RuhaanSJ/Smartwatch/Features.docx

Features

1. Time
2. Stopwatch
3. Alarm with vibration
4. Step Tracker
5. Notifications Readout
6. USB C charging port
7. Reminders Readout
8. Weather Forecast Readout
9. Phone Media control (play, pause, skip, etc.)
