RuhaanSJ/Smartwatch/Hardware/Extra/Top/Smartwatch-EXTRA-TOP_BOM.xlsx

Design Name -- Revision Code / Designer or Organization Name |  |  |  |  |  |  |  |  |  |  | Total | $32.52 | Total (in Bulk) | $27.30
BOM # | Comment | Designator | Description | Mounting Type | Package | Manufacturer | Manufacturer Part Number | Supplier | Supplier Part Number | Price per unit | Quantity | Total | Per 100 | Total
 | DigiKey
1 | NRF52832_MODULE_MDBT42 | U1 | Bluetooth Bluetooth v4.2 Transceiver Module 2.4GHz Integrated, Chip Surface Mount | SMD | 41-SMD Module | Seeed Technology Co., Ltd | 317030213 | Digi-Key | 1597-1434-ND | $10.10 | 1 | $10.10 | $10.10 | $10.10 | a
2 | FT231XS USB Serial | U3 | USB Bridge, USB to UART USB 2.0 UART Interface 20-SSOP | SMD | 20-SSOP | FTDI, Future Technology Devices International Ltd | FT231XS-U | Digi-Key | 768-1156-5-ND | $2.12 | 1 | $2.12 | $2.08 | $2.08 | a
3 | MIC5504-3.3V | LDO1 | Linear Voltage Regulator IC 1 Output 300mA SOT-23-5 | SMD | SOT23-5 | Microchip Technology | MIC5504-3.3YM5-TR | Digi-Key | 576-4764-1-ND | $0.11 | 1 | $0.11 | $0.08 | $0.08 | a
4 | MCP73831 T Li-Ion, Li-Pol Controller | CHRG1 | Charger IC Lithium-Ion/Polymer SOT-23-5 | SMD | SOT-23-5 | Microchip Technology | MCP73831T-2ACI/OT | Digi-Key | MCP73831T-2ACI/OTCT-ND | $0.56 | 1 | $0.56 | $0.44 | $0.44 | a
5 | CRYSTALECS-.327-12.5-12-C-TR (CRYSTAL) (32.7680kHz) | XTAL1 | 32.768kHz ±10ppm Crystal 12.5pF 90 kOhms 2-SMD, No Lead | SMD | 2-SMD, No Lead | ECS Inc. | ECS-.327-12.5-12-C-TR | Digi-Key | XC2288CT-ND | $0.60 | 1 | $0.60 | $0.54 | $0.54
6 | Cortex Debug Connector - 10 pin | DEBUG1 | Connector Header Through Hole 10 position 0.050" (1.27mm) | THT | NA | Amphenol ICC (FCI) | 20021111-00010T4LF | Digi-Key | 609-3712-ND | $0.69 | 1 | $0.69 | $0.53 | $0.53
7 | Schottky Diode | D1,D2,D3,D4 | Diode Schottky 30V 1.5A Surface Mount USC | SMD | USC | Toshiba Semiconductor and Storage | CUS15S30,H3F | Digi-Key | CUS15S30H3FCT-ND | $0.26 | 5 | $1.28 | $0.13 | $0.64
8 | Red LED | LED1,LED3 | Red 622nm LED Indication - Discrete 2.2V 0603 (1608 Metric) | SMD | 0603 | Inolux | IN-S63ATR | Digi-Key | 1830-1065-1-ND | $0.18 | 2 | $0.35 | $0.09 | $0.17
9 | Blue LED | LED2 | Blue 470nm LED Indication - Discrete 3V 0603 (1608 Metric) | SMD | 0603 | Inolux | IN-S63AT5B | Digi-Key | 1830-1061-1-ND | $0.18 | 1 | $0.18 | $0.09 | $0.09
10 | Yellow LED | LED4 | Yellow 590nm LED Indication - Discrete 2V 0603 (1608 Metric) | SMD | 0603 | Wurth Electronics Inc. | 150060YS75000 | Digi-Key | 732-4981-1-ND | $0.14 | 1 | $0.14 | $0.11 | $0.11
11 | Ambient Light Sensor | U4 | Optical Sensor Ambient 630nm Analog 0603 (1608 Metric) | SMD | 0603 | Inolux | IN-S63DTLS | Digi-Key | 1830-IN-S63DTLSCT-ND | $0.55 | 1 | $0.55 | $0.26 | $0.26
12 | MCP9808-MSOP8 | U5 | Temperature Sensor Digital, Local -40°C ~ 125°C 10 b 8-MSOP | SMD |  | Microchip Technology | MCP9808T-E/MS | Digi-Key | MCP9808T-E/MSTR-ND | $1.13 | 1 | $1.13 | $0.85 | $0.85
13 | NFET | Q1 | N-Channel 30V 500mA (Ta) 690mW (Ta) Surface Mount SOT-23-3 (TO-236) | SMD | SOT23-3 | ON Semiconductor | NTR4003NT3G | Digi-Key | NTR4003NT3GOSCT-ND | $0.27 | 1 | $0.27 | $0.09 | $0.09
14 | Vibration Motor | M1 | DC Motor Vibration, ERM 10000 RPM 3VDC | THT | Wire Leads | Jinlong Machinery & Electronics, Inc. | C0720B015F | Digi-Key | 1670-1030-ND | $3.54 | 1 | $3.54 | $2.61 | $2.61
15 | Micro USB | USB2 | USB - micro B USB 2.0 Receptacle Connector 5 Position Surface Mount, Right Angle | SMD | Flange, Horizontal | Amphenol FCI | 10118192-0001LF | Digi-Key | 609-4613-1-ND | $0.43 | 1 | $0.43 | $0.32 | $0.32
16 | CONN_07-1.27MM | J1,J3,J4 | 50 Positions Header Connector 0.050" (1.27mm) Through Hole Gold | THT |  | Sullins Connector Solutions | GRPB501VWVN-RC | Digi-Key | S9014E-50-ND | $3.11 | 3 | $9.33 | $2.49 | $7.47
17 | Tiny Rectangular Switch | SW1,SW2 | Tactile Switch SPST-NO Top Actuated Surface Mount | SMD | Gull Wing | C&K Components | PTS830GM140 SMTR LFS | Digi-Key | CKN10587CT-ND | $0.57 | 2 | $1.14 | $0.46 | $0.91
18 | 10µH Inductor | L1 | 10µH Shielded Multilayer Inductor 250mA 1.05Ohm 0603 (1608 Metric) | SMD | 0603 | TDK Corporation | MLZ1608M100WTD25 | Digi-Key | MLZ1608M100WTD25 | $0.22 | 1 | $0.22 | $0.13 | $0.13
19 | 27 ohm resistor | R9, R10 | 27 Ohms ±1% 0.1W, 1/10W Chip Resistor 0603 (1608 Metric) Automotive AEC-Q200 Thick Film | SMD | 0603 | Stackpole Electronics Inc | RMCF0603FT27R0 | Digi-Key | RMCF0603FT27R0CT-ND | $0.01 | 2 | $0.01 | $0.01 | $0.01
20 | 1k Resistor | R3,R4,R15, R16 | 1 kOhms ±1% 0.1W, 1/10W Chip Resistor 0603 (1608 Metric) Automotive AEC-Q200 Thick Film | SMD | 0603 | Stackpole Electronics Inc | RMCF0603FT1K00 | Digi-Key | RMCF0603FT1K00CT-ND | $0.01 | 4 | $0.02 | $0.01 | $0.03
21 | 10k Resistor | R1,R2,R5,R7,R17,R18,R19 | 10 kOhms ±1% 0.1W, 1/10W Chip Resistor 0603 (1608 Metric) Automotive AEC-Q200 Thick Film | SMD | 0603 | Stackpole Electronics Inc | RMCF0603FT10K0 | Digi-Key | RMCF0603FT10K0CT-ND | $0.01 | 6 | $0.04 | $0.01 | $0.04
22 | 100k Resistor | R8,R12,R13,R14 | 100 kOhms ±1% 0.1W, 1/10W Chip Resistor 0603 (1608 Metric) Automotive AEC-Q200 Thick Film | SMD | 0603 | Stackpole Electronics Inc | RMCF0603FT100K | Digi-Key | RMCF0603FT100KCT-ND | $0.01 | 4 | $0.02 | $0.01 | $0.03
23 | 4.7k resistor | R11 | 4.7 kOhms ±1% 0.1W, 1/10W Chip Resistor 0603 (1608 Metric) Automotive AEC-Q200 Thick Film | SMD | 0603 | Stackpole Electronics Inc | RMCF0603FT4K70 | Digi-Key | RMCF0603FT4K70CT-ND | $0.01 | 1 | $0.01 | $0.01 | $0.01
24 | 390k resistor | R6 | 390 kOhms ±1% 0.1W, 1/10W Chip Resistor 0603 (1608 Metric) Automotive AEC-Q200 Thick Film | SMD | 0603 | Stackpole Electronics Inc | RMCF0603FG390K | Digi-Key | RMCF0603FG390KCT-ND | $0.01 | 2 | $0.01 | $0.01 | $0.01
25 | 47 pF Capacitor | C7, C9 | 47pF ±5% 50V Ceramic Capacitor C0G, NP0 0603 (1608 Metric) | SMD | 0603 | Walsin Technology Corporation | 0603N470J500CT | Digi-Key | 1292-1528-1-ND | $0.01 | 2 | $0.02 | $0.01 | $0.01
26 | 12pF capacitor | C3,C4 | 12pF ±5% 50V Ceramic Capacitor C0G, NP0 0603 (1608 Metric) | SMD | 0603 | Walsin Technology Corporation | 0603N120J500CT | Digi-Key | 1292-1480-1-ND | $0.01 | 100 | $1.19
27 | 100 nF Capacitor | C5,C10,C14,C17 | 0.1µF ±5% 16V Ceramic Capacitor X7R 0603 (1608 Metric) | SMD | 0603 | Yageo | CC0603JRX7R7BB104 | Digi-Key | 311-1776-1-ND | $0.03 | 4 | $0.13 | $0.03 | $0.14
28 | 1uF capacitor | C1,C8,C11,C16 | 1µF ±10% 25V Ceramic Capacitor X5R 0603 (1608 Metric) | SMD | 0603 | Samsung Electro-Mechanics | CL10A105KA8NNNC | Digi-Key | 1276-1102-1-ND | $0.10 | 4 | $0.40 | $0.02 | $0.07
29 | 2.2u capacitor | C13,C18,C19,C21,C22,C23 | 2.2µF ±10% 16V Ceramic Capacitor X5R 0603 (1608 Metric) | SMD | 0603 | Samsung Electro-Mechanics | CL10A225KO8NNNC | Digi-Key | 1276-1040-1-ND | $0.03 | 6 | $0.19 | $0.03 | $0.20
30 | 4.7 uF Capacitor | C6, C12 | red 622nm LED Indication - Discrete 2.2V 0603 (1608 Metric) | SMD | 0603 | Samsung Electro-Mechanics | CL10A475KO8NNNC | Digi-Key | 1276-1784-1-ND | $0.04 | 2 | $0.09 | $0.04 | $0.09
31 | 10 uF 0603 Capacitor | C2,C20 | 10µF ±10% 10V Ceramic Capacitor X5R 0603 (1608 Metric) | SMD | 0603 | Murata Electronics | GRM188R61A106KE69J | Digi-Key | 490-14372-1-ND | $0.06 | 2 | $0.13 | $0.25 | $0.51
32 | J-LINK EDU |  | JTAG EMULATOR FOR ARM CORES - ARM7®, ARM9®, Cortex® - Emulator | NA | NA | Segger Microcontroller Systems | 8.08.90 J-LINK EDU | Digi-Key | 899-1008-ND | $63.75 | 1 | $63.75 | $63.75 | $63.75
33 | J-LINK 9-PIN CORTEX-M ADAPTER |  | Cortex®-M Devices - Adapter Board - J-LINK 9-PIN CORTEX-M ADAPTER | NA | NA | Segger Microcontroller Systems | 8.06.02 J-LINK 9-PIN CORTEX-M ADAPTER | Digi-Key | 899-1012-ND | $31.88 | 1 | $31.88 | $31.88 | $31.88
34 | 0 ohm resistor (not sure if needed) | JP1 | 0 Ohms Jumper 0.1W, 1/10W Chip Resistor 0603 (1608 Metric) Moisture Resistant Thick Film | SMD | 0603 | Yageo | RC0603JR-070RL | Digi-Key | 311-0.0GRCT-ND | $0.01 | 1 | $0.01 | $0.01 | $0.01
35 | 9V Battery Connector | J2 | Battery Connector, Snap 9V 1 Cell Wire Leads - 4" (101.6mm) | THT |  | Keystone Electronics | 81-4 | Digi-Key | 36-81-4-ND | $0.55 | 1 | $0.55 | $0.40 | $0.40
36 | 10 pF Capacitor | C15 | ±5% 50V Ceramic Capacitor C0G, NP0 0603 (1608 Metric) | SMD | 0603 | Samsung Electro-Mechanics | CL10C100JB8NNNC | Digi-Key | 1276-1027-2-ND | 0.1 | 1 | $0.10 | $0.02 | $0.02
37 | Micro USB | USB1 | USB - micro B USB 2.0 Receptacle Connector 5 Position Surface Mount, Right Angle | SMD | Flange, Horizontal | Amphenol FCI | 10118192-0001LF | Digi-Key | 609-4613-1-ND | $0.43 | 1 | $0.43 | $0.32 | $0.32
38 | 350 mAh LiPo Battery | BT1 | 3.7V Lithium Polymer Battery Rechargeable (Secondary) 350mAh | JST | JST PH Connector | Adafruit Industries LLC | 4237 | Digi-Key | 1528-4237-ND | $5.95 | 3 | $17.85
