RuhaanSJ/Smartwatch/Hardware/Extra/Bottom/Smartwatch-EXTRA-BOTTOM_BOM.xlsx

Design Name -- Revision Code / Designer or Organization Name |  |  |  |  |  |  |  |  |  |  | Total | $12.41 | Total (in Bulk) | $5.11
BOM # | Comment | Designator | Description | Mounting Type | Package | Manufacturer | Manufacturer Part Number | Supplier | Supplier Part Number | Price per unit | Quantity | Total | Per 100 | Total
 | DigiKey
1 | LSM6DS3 castellated breakout | IMU1 |  |  |  |  |  |  |  |  | 1 | $0.00 |  | $0.00
2 | MCP6001 |  | General Purpose Amplifier 1 Circuit Rail-to-Rail SOT-23-5 | SMD | SOT-23-5 | Microchip Technology | MCP6001T-E/OTCT-ND | Digi-Key | MCP6001T-E/OTCT-ND | $0.29 | 1 | $0.29 | $0.22 | $0.22
3 | Op Amp - MCP6004 | OP3 | General Purpose Amplifier 4 Circuit Rail-to-Rail 14-SOIC | SMD | 14-SOIC | Microchip Technology | MCP6004T-I/SL | Digi-Key | MCP6004T-I/SLCT-ND | $0.44 | 1 | $0.44 | $0.33 | $0.33
4 | TIA | OP4 | General Purpose Amplifier 1 Circuit Rail-to-Rail SOT-23-5 | SMD | SOT-23-5 | Microchip Technology | MCP6001T-I/OT | Digi-Key | MCP6001T-I/OTCT-ND | $0.24 | 1 | $0.24 | $0.18 | $0.18
5 | AD5242 | U1 | Digital Potentiometer 1M Ohm 2 Circuit 256 Taps I²C Interface 16-SOIC | SMD | 16-SOIC | Analog Devices Inc. | AD5242BRZ1M | Digi-Key | AD5242BRZ1M-ND | $3.47 | 1 | $3.47 | $2.71 | $2.71
6 | PCF8523 | U2 | Real Time Clock (RTC) IC Clock/Calendar I²C, 2-Wire Serial 8-SOIC (0.154", 3.90mm Width) | SMD | 8-SO | NXP USA Inc. | PCF8523T/1,118 | Digi-Key | 568-5306-1-ND | $1.26 | 1 | $1.26 | $1.09 | $1.09
7 | NPN-Generic | Q1 | Bipolar (BJT) Transistor NPN 40V 600mA 300MHz 250mW Surface Mount TO-236AB | SMD | TO-236AB | Nexperia USA Inc. | PMBT2222A,215 | Digi-Key | 1727-2956-1-ND | $1.05 | 1 | $1.05 | $0.04 | $0.04
8 | CRYSTALECS-.327-12.5-12-C-TR (CRYSTAL) (32.7680kHz) | XTAL1 | 32.768kHz ±10ppm Crystal 12.5pF 90 kOhms 2-SMD, No Lead | SMD | 2-SMD, No Lead | ECS Inc. | ECS-.327-12.5-12-C-TR | Digi-Key | XC2288CT-ND | $0.60 | 1 | $0.60 | $0.54 | $0.54
55 | CONN_07-1.27MM (CONN_07) | J1,J2 | 50 Position Header Connector 0.050" (1.27mm) Through Hole Gold | THT |  | Sullins Connector Solutions | LPPB501NFFN-RC | Digi-Key | S9008E-50-ND | $5.06 | 1 | $5.06
56 | 10k Resistor | R1,R2,R7,R8,R14,R15,R16,R17,R18 | 10 kOhms ±1% 0.1W, 1/10W Chip Resistor 0603 (1608 Metric) Automotive AEC-Q200 Thick Film | SMD | 0603 | Stackpole Electronics Inc | RMCF0603FT10K0 | Digi-Key | RMCF0603FT10K0CT-ND | $0.01 | 9 | $0.05 | $0.01 | $0.06
57 | 220k resistor | R3,R5,R9,R11 | 220 kOhms ±1% 0.1W, 1/10W Chip Resistor 0603 (1608 Metric) Automotive AEC-Q200 Thick Film | SMD | 0603 | Stackpole Electronics Inc | RMCF0603FT220K | Digi-Key | RMCF0603FT220KCT-ND | $0.01 | 4 | $0.02 | $0.01 | $0.03
58 | 1M Resistor | R10,R13 | 1 MOhms ±1% 0.1W, 1/10W Chip Resistor 0603 (1608 Metric) Automotive AEC-Q200 Thick Film | SMD | 0603 | Stackpole Electronics Inc | RMCF0603FT1M00 | Digi-Key | RMCF0603FT1M00CT-ND | $0.01 | 2 | $0.01 | $0.01 | $0.01
59 | 10M Resistor | R4,R12 | 10 MOhms ±1% 0.1W, 1/10W Chip Resistor 0603 (1608 Metric) Automotive AEC-Q200 Thick Film | SMD | 0603 | Stackpole Electronics Inc | RMCF0603FT10M0 | Digi-Key | RMCF0603FT10M0CT-ND | $0.01 | 2 | $0.02 | $0.01 | $0.01
60 | 2.2n Capacitor | C5,C10 | 2200pF ±10% 50V Ceramic Capacitor X7R 0603 (1608 Metric) | SMD | 0603 | Walsin Technology Corporation | 0603B222K500CT | Digi-Key | 1292-1412-1-ND | $0.01 | 2 | $0.02 | $0.01 | $0.02
61 | 22n capacitor | C12 | 0.022µF ±10% 50V Ceramic Capacitor X7R 0603 (1608 Metric) | SMD | 0603 | Samsung Electro-Mechanics | CL10B223KB8NNNC | Digi-Key | 1276-1104-1-ND | $0.02 | 1 | $0.02 | $0.02 | $0.02
62 | 100 nF Capacitor | C1,C3,C4,C8,C9,C13 | 0.1µF ±5% 16V Ceramic Capacitor X7R 0603 (1608 Metric) | SMD | 0603 | Yageo | CC0603JRX7R7BB104 | Digi-Key | 311-1776-1-ND | $0.03 | 6 | $0.20 | $0.03 | $0.21
63 | 1uF capacitor | C2 | 1µF ±10% 25V Ceramic Capacitor X5R 0603 (1608 Metric) | SMD | 0603 | Samsung Electro-Mechanics | CL10A105KA8NNNC | Digi-Key | 1276-1102-1-ND | $0.10 | 1 | $0.10 | $0.02 | $0.02
64 | 2.2u capacitor | C6,C7 | 2.2µF ±10% 16V Ceramic Capacitor X5R 0603 (1608 Metric) | SMD | 0603 | Samsung Electro-Mechanics | CL10A225KO8NNNC | Digi-Key | 1276-1040-1-ND | $0.03 | 2 | $0.06 | $0.03 | $0.07
65 | 22u capacitor | C11 | 22µF ±20% 10V Ceramic Capacitor X5R 0603 (1608 Metric) | SMD | 0603 | Samsung Electro-Mechanics | CL10A226MP8NUNE | Digi-Key | 1276-1274-1-ND | $0.07 | 1 | $0.07 | $0.07 | $0.07
66 | 10 nF capacitor | C14,C15 | ±10% 16V Ceramic Capacitor X7R 0402 (1005 Metric) | SMD | 0604 | Samsung Electro-Mechanics | CL05B103KO5NNNC | Digi-Key | 1276-1051-2-ND | $0.10 | 2 | $0.20 | $0.01 | $0.01
67 | Encoder | ENC1 | Rotary Encoder Mechanical 12 Quadrature (Incremental) Vertical | THT |  | Panasonic Electronic Components | EVQ-VUA00112B | Digi-Key | P123413-ND | $1.18 | 1 | $1.18 | $0.81 | $0.81
68 | Tactile Button | B1 | SWITCH TACTILE SPST-NO 1VA 32V | SMD |  | C&K | KT11P2SA1M35LFG | Digi-Key | CKN1843CT-ND | $4.47 | 1 | $4.47 | $3.39 | $3.39
 | Mouser |  |  |  |  |  |  |  |  |  |  |  |  | $0.00
22 | AD5171 | U3 | Digital Potentiometer ICs IC 6-Bit OTP I2C | SMD | SOT-23-8 | Analog Devices | AD5171BRJZ100-R7 | Mouser | 584-AD5171BRJZ100-R7 | $2.68 | 1 | $2.68 | $1.82 | $1.82
