RuhaanSJ/Smartwatch/Hardware/Basic/Top/Smartwatch-BASIC-TOP_BOM.xlsx

Design Name -- Revision Code / Designer or Organization Name |  |  |  |  |  |  |  |  |  |  | Total | $28.04 | Total (in Bulk) | $0.48
BOM # | Comment | Designator | Description | Mounting Type | Package | Manufacturer | Manufacturer Part Number | Supplier | Supplier Part Number | Price per unit | Quantity | Total | Per 100 | Total
 | DigiKey
1 | NRF52832_MODULE_MDBT42 | U2 | Bluetooth Bluetooth v4.2 Transceiver Module 2.4GHz Integrated, Chip Surface Mount | SMD | 41-SMD Module | Seeed Technology Co., Ltd | 317030213 | Digi-Key | 1597-1434-ND | $10.10 | 1 | $10.10 |  |  | a
3 | FT231XS USB Serial | U4 | USB Bridge, USB to UART USB 2.0 UART Interface 20-SSOP | SMD | 20-SSOP | FTDI, Future Technology Devices International Ltd | FT231XS-U | Digi-Key | 768-1156-5-ND | $2.12 | 1 | $2.12 |  |  | a
8 | 350 mAh LiPo Battery |  | 3.7V Lithium-Ion Battery Rechargeable (Secondary) 350mAh | JST | JST PH Connector | Adafruit Industries LLC | 2750 | Digi-Key | 1528-1858-ND | $6.95 | 1 | $6.95 |  |  | a
9 | 9V Battery Connector | 9V | Battery Connector, Snap 9V 1 Cell Wire Leads - 4" (101.6mm) | THT |  | Keystone Electronics | 81-4 | Digi-Key | 36-81-4-ND | $0.55 | 1 | $0.55 | $0.40 | $0.40 | a
13 | MIC5504-3.3V | LDO1 | Linear Voltage Regulator IC 1 Output 300mA SOT-23-5 | SMD | SOT23-5 | Microchip Technology | MIC5504-3.3YM5-TR | Digi-Key | 576-4764-1-ND | $0.11 | 1 | $0.11 | $0.08 | $0.08 | a
15 | MCP73831 T Li-Ion, Li-Pol Controller | CHRG1 | Charger IC Lithium-Ion/Polymer SOT-23-5 | SMD | SOT-23-5 | Microchip Technology | MCP73831T-2ACI/OT | Digi-Key | MCP73831T-2ACI/OTCT-ND | $0.56 | 1 | $0.56 |  |  | a
28 | CRYSTALECS-.327-12.5-12-C-TR (CRYSTAL) (32.7680kHz) | XTAL1 | 32.768kHz ±10ppm Crystal 12.5pF 90 kOhms 2-SMD, No Lead | SMD | 2-SMD, No Lead | ECS Inc. | ECS-.327-12.5-12-C-TR | Digi-Key | XC2288CT-ND | $0.60 | 1 | $0.60
33 | Cortex Debug Connector - 10 pin | CORTEX1 | Connector Header Through Hole 10 position 0.050" (1.27mm) | THT | NA | Amphenol ICC (FCI) | 20021111-00010T4LF | Digi-Key | 609-3712-ND | $0.69 | 1 | $0.69
34 | Schottky Diode | D1,D2,D3 | Diode Schottky 30V 1.5A Surface Mount USC | SMD | USC | Toshiba Semiconductor and Storage | CUS15S30,H3F | Digi-Key | CUS15S30H3FCT-ND | $0.26 | 3 | $0.77
36 | Red LED | LED1,LED3 | Red 622nm LED Indication - Discrete 2.2V 0603 (1608 Metric) | SMD | 0603 | Inolux | IN-S63ATR | Digi-Key | 1830-1065-1-ND | $0.18 | 2 | $0.35
37 | Blue LED | LED2 | Blue 470nm LED Indication - Discrete 3V 0603 (1608 Metric) | SMD | 0603 | Inolux | IN-S63AT5B | Digi-Key | 1830-1061-1-ND | $0.18 | 1 | $0.18
38 | Yellow LED | LED4 | Yellow 590nm LED Indication - Discrete 2V 0603 (1608 Metric) | SMD | 0603 | Wurth Electronics Inc. | 150060YS75000 | Digi-Key | 732-4981-1-ND | $0.14 | 1 | $0.14
 |  |  |  |  |  |  |  |  |  |  |  | $0.00 |  | $0.00
 |  |  |  |  |  |  |  |  |  |  |  | $0.00 |  | $0.00
 |  |  |  |  |  |  |  |  |  |  |  | $0.00 |  | $0.00
 |  |  |  |  |  |  |  |  |  |  |  | $0.00 |  | $0.00
50 | SWITCH.MOM (TACTILE_SWITCH_SMD_6.2MM_TALL) | SW2,SW3 | Tactile Switch SPST-NO Top Actuated Surface Mount - TACT 4.5 X 4.5, 7.0 MM H, 1.0N, | SMD | Gull Wing | C&K | PTS 647 SN70 SMTR2 LFS | Digi-Key | PTS647SN70SMTR2LFSCT-ND | $0.12 | 2 | $0.24
52 | Micro USB | USB2 | USB - micro B USB 2.0 Receptacle Connector 5 Position Surface Mount, Right Angle | SMD | Flange, Horizontal | Amphenol FCI | 10118192-0001LF | Digi-Key | 609-4613-1-ND | $0.43 | 1 | $0.43
56 | CONN_07-1.27MM | J1 | 50 Positions Header Connector 0.050" (1.27mm) Through Hole Gold | THT |  | Sullins Connector Solutions | GRPB501VWVN-RC | Digi-Key | S9014E-50-ND | $3.11 | 1 | $3.11
58 | Tiny Rectangular Switch | SW1,SW4 | Tactile Switch SPST-NO Top Actuated Surface Mount | SMD | Gull Wing | C&K Components | PTS830GM140 SMTR LFS | Digi-Key | CKN10587CT-ND | $0.57 | 2 | $1.14 |  | $0.00
63 | 10µH Inductor | L1 | 10µH Shielded Multilayer Inductor 250mA 1.05Ohm 0603 (1608 Metric) | SMD | 0603 | TDK Corporation | MLZ1608M100WTD25 | Digi-Key | MLZ1608M100WTD25 | $0.22 | 1 | $0.22 | $0.13 | $0.13
66 | 27 ohm resistor | R9, R14 | 27 Ohms ±1% 0.1W, 1/10W Chip Resistor 0603 (1608 Metric) Automotive AEC-Q200 Thick Film | SMD | 0603 | Stackpole Electronics Inc | RMCF0603FT27R0 | Digi-Key | RMCF0603FT27R0CT-ND | $0.01 | 2 | $0.01
67 | 1k Resistor | R3,R4,R15, R16 | 1 kOhms ±1% 0.1W, 1/10W Chip Resistor 0603 (1608 Metric) Automotive AEC-Q200 Thick Film | SMD | 0603 | Stackpole Electronics Inc | RMCF0603FT1K00 | Digi-Key | RMCF0603FT1K00CT-ND | $0.01 | 4 | $0.02
69 | 10k Resistor | R1,R2,R5,R6 | 10 kOhms ±1% 0.1W, 1/10W Chip Resistor 0603 (1608 Metric) Automotive AEC-Q200 Thick Film | SMD | 0603 | Stackpole Electronics Inc | RMCF0603FT10K0 | Digi-Key | RMCF0603FT10K0CT-ND | $0.01 | 100 | $0.59
70 | 100k Resistor | R8,R11,R12,R13 | 100 kOhms ±1% 0.1W, 1/10W Chip Resistor 0603 (1608 Metric) Automotive AEC-Q200 Thick Film | SMD | 0603 | Stackpole Electronics Inc | RMCF0603FT100K | Digi-Key | RMCF0603FT100KCT-ND | $0.01 | 4 | $0.02
68 | 4.7k resistor | R10 | 4.7 kOhms ±1% 0.1W, 1/10W Chip Resistor 0603 (1608 Metric) Automotive AEC-Q200 Thick Film | SMD | 0603 | Stackpole Electronics Inc | RMCF0603FT4K70 | Digi-Key | RMCF0603FT4K70CT-ND | $0.01 | 1 | $0.01
72 | 390k resistor | R7 | 390 kOhms ±1% 0.1W, 1/10W Chip Resistor 0603 (1608 Metric) Automotive AEC-Q200 Thick Film | SMD | 0603 | Stackpole Electronics Inc | RMCF0603FG390K | Digi-Key | RMCF0603FG390KCT-ND | $0.01 | 1 | $0.01
79 | 47 pF Capacitor | C15,C17 | 47pF ±5% 50V Ceramic Capacitor C0G, NP0 0603 (1608 Metric) | SMD | 0603 | Walsin Technology Corporation | 0603N470J500CT | Digi-Key | 1292-1528-1-ND | $0.01 | 2 | $0.02
80 | 300 pF Capacitor |  | 120pF ±5% 50V Ceramic Capacitor C0G, NP0 0603 (1608 Metric) | SMD | 0603 | Walsin Technology Corporation | 0603N121J500CT | Digi-Key | 1292-1481-1-ND | $0.02 | 100 | $1.75
82 |  |  | 0.022µF ±10% 50V Ceramic Capacitor X7R 0603 (1608 Metric) | SMD | 0603 | Samsung Electro-Mechanics | CL10B223KB8NNNC | Digi-Key | 1276-1104-1-ND | $0.02 | 100 | $1.56
83 | 100 nF Capacitor | C13,C18 | 0.1µF ±5% 16V Ceramic Capacitor X7R 0603 (1608 Metric) | SMD | 0603 | Yageo | CC0603JRX7R7BB104 | Digi-Key | 311-1776-1-ND | $0.03 | 2 | $0.07
84 | 1uF capacitor | C1,C16,C19 | 1µF ±10% 25V Ceramic Capacitor X5R 0603 (1608 Metric) | SMD | 0603 | Samsung Electro-Mechanics | CL10A105KA8NNNC | Digi-Key | 1276-1102-1-ND | $0.10 | 3 | $0.30 | $0.02 | $0.02
85 | 2.2u capacitor | C8,C9,C10,C11,C12 | 2.2µF ±10% 16V Ceramic Capacitor X5R 0603 (1608 Metric) | SMD | 0603 | Samsung Electro-Mechanics | CL10A225KO8NNNC | Digi-Key | 1276-1040-1-ND | $0.03 | 5 | $0.16
86 | 4.7 uF Capacitor | C14,C20 | red 622nm LED Indication - Discrete 2.2V 0603 (1608 Metric) | SMD | 0603 | Samsung Electro-Mechanics | CL10A475KO8NNNC | Digi-Key | 1276-1784-1-ND | $0.04 | 2 | $0.09
87 | 10 uF 0603 Capacitor | C2,C7 | 10µF ±10% 10V Ceramic Capacitor X5R 0603 (1608 Metric) | SMD | 0603 | Murata Electronics | GRM188R61A106KE69J | Digi-Key | 490-14372-1-ND | $0.06 | 2 | $0.13
90 | J-LINK EDU |  | JTAG EMULATOR FOR ARM CORES - ARM7®, ARM9®, Cortex® - Emulator | NA | NA | Segger Microcontroller Systems | 8.08.90 J-LINK EDU | Digi-Key | 899-1008-ND | $63.75 | 1 | $63.75
91 | J-LINK 9-PIN CORTEX-M ADAPTER |  | Cortex®-M Devices - Adapter Board - J-LINK 9-PIN CORTEX-M ADAPTER | NA | NA | Segger Microcontroller Systems | 8.06.02 J-LINK 9-PIN CORTEX-M ADAPTER | Digi-Key | 899-1012-ND | $31.88 | 1 | $31.88
