RuhaanSJ/Smartwatch/Hardware/Extra/Top/Smartwatch-EXTRA-TOP.brd

## EAGLE design Hardware/Extra/Top/Smartwatch-EXTRA-TOP.brd (2021-04-10)

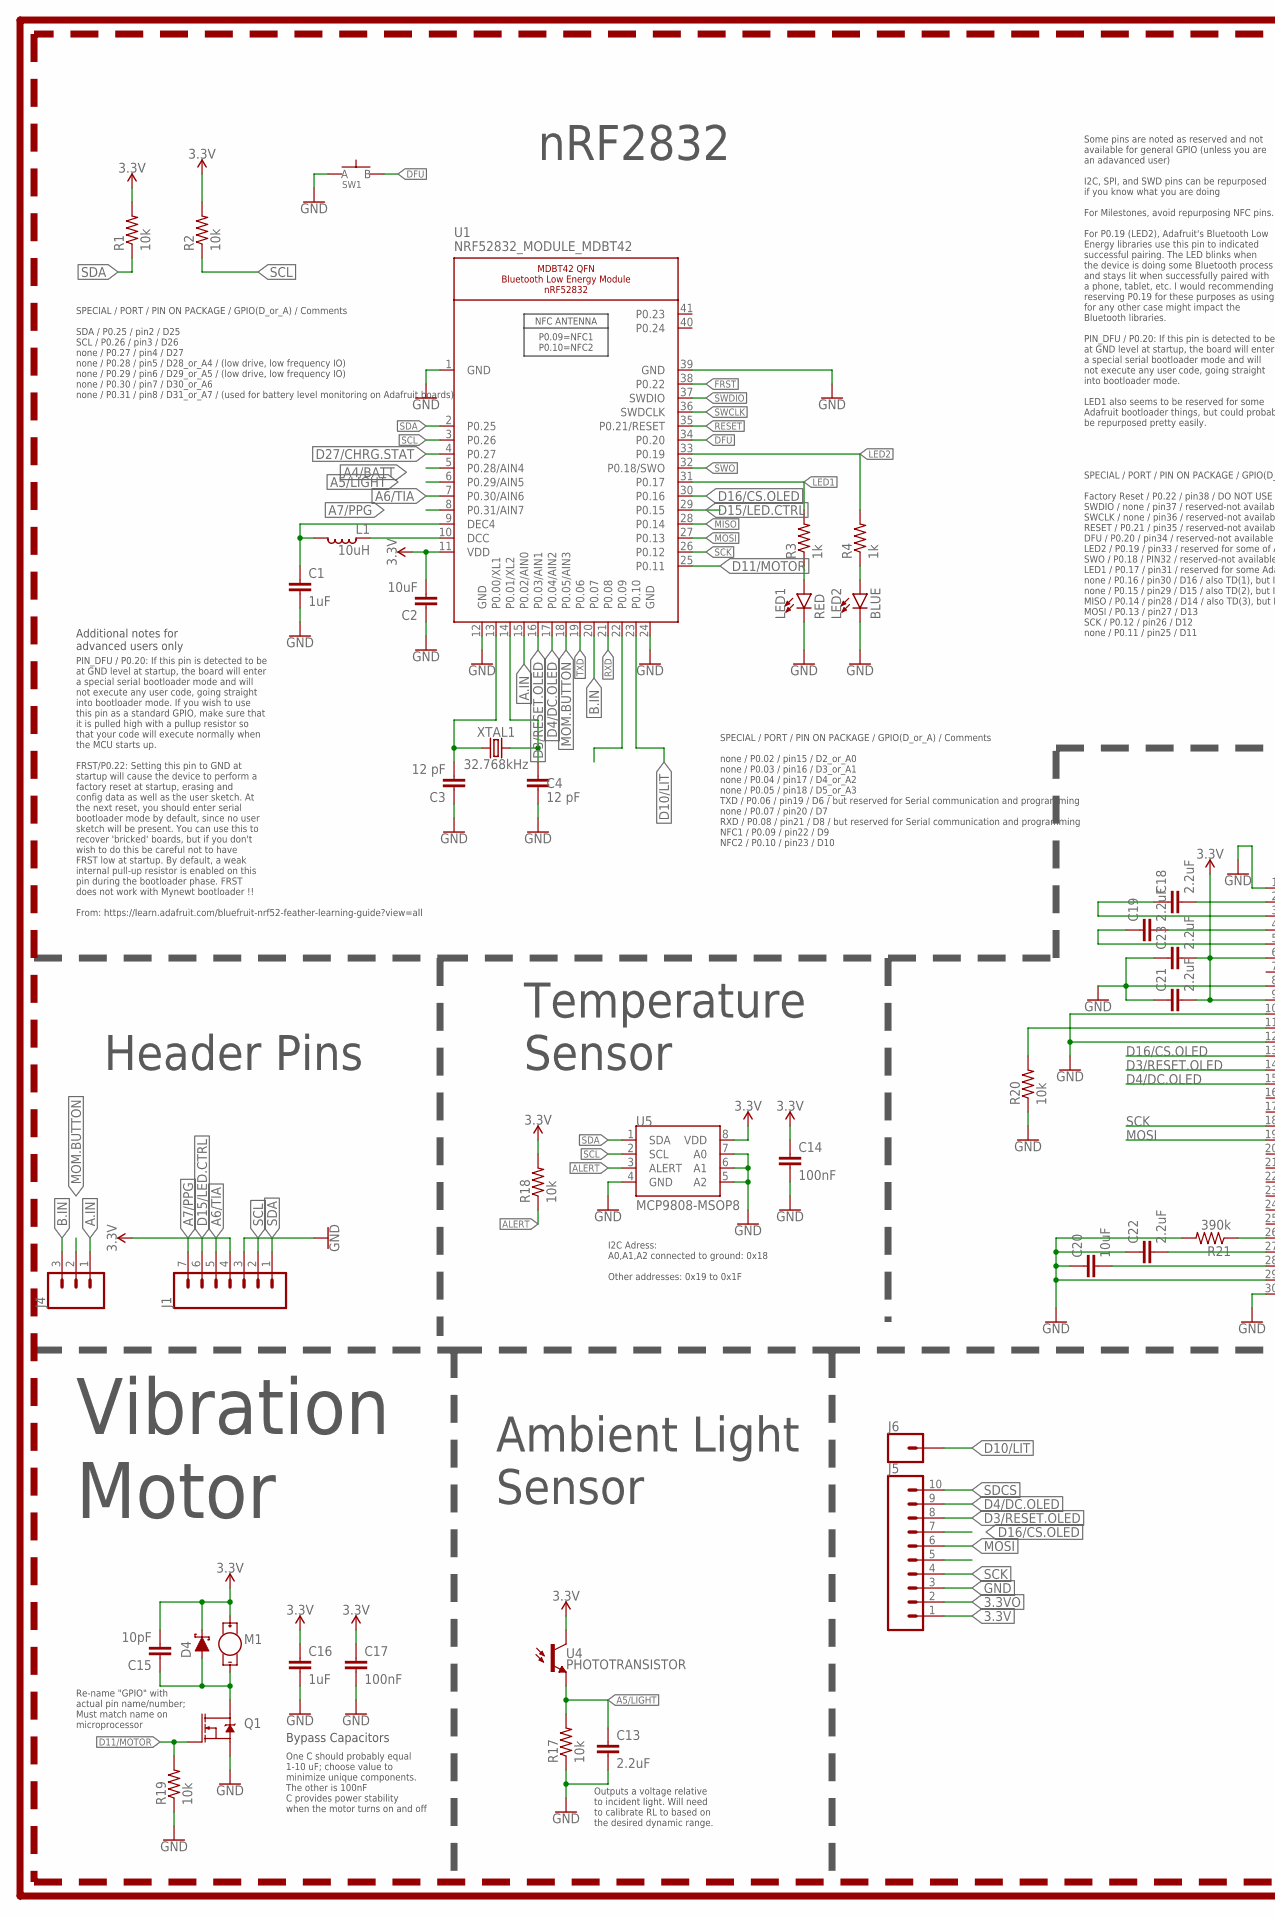
[picture p1: schematic Smartwatch-EXTRA-TOP.sch, part in row 1, column 1]

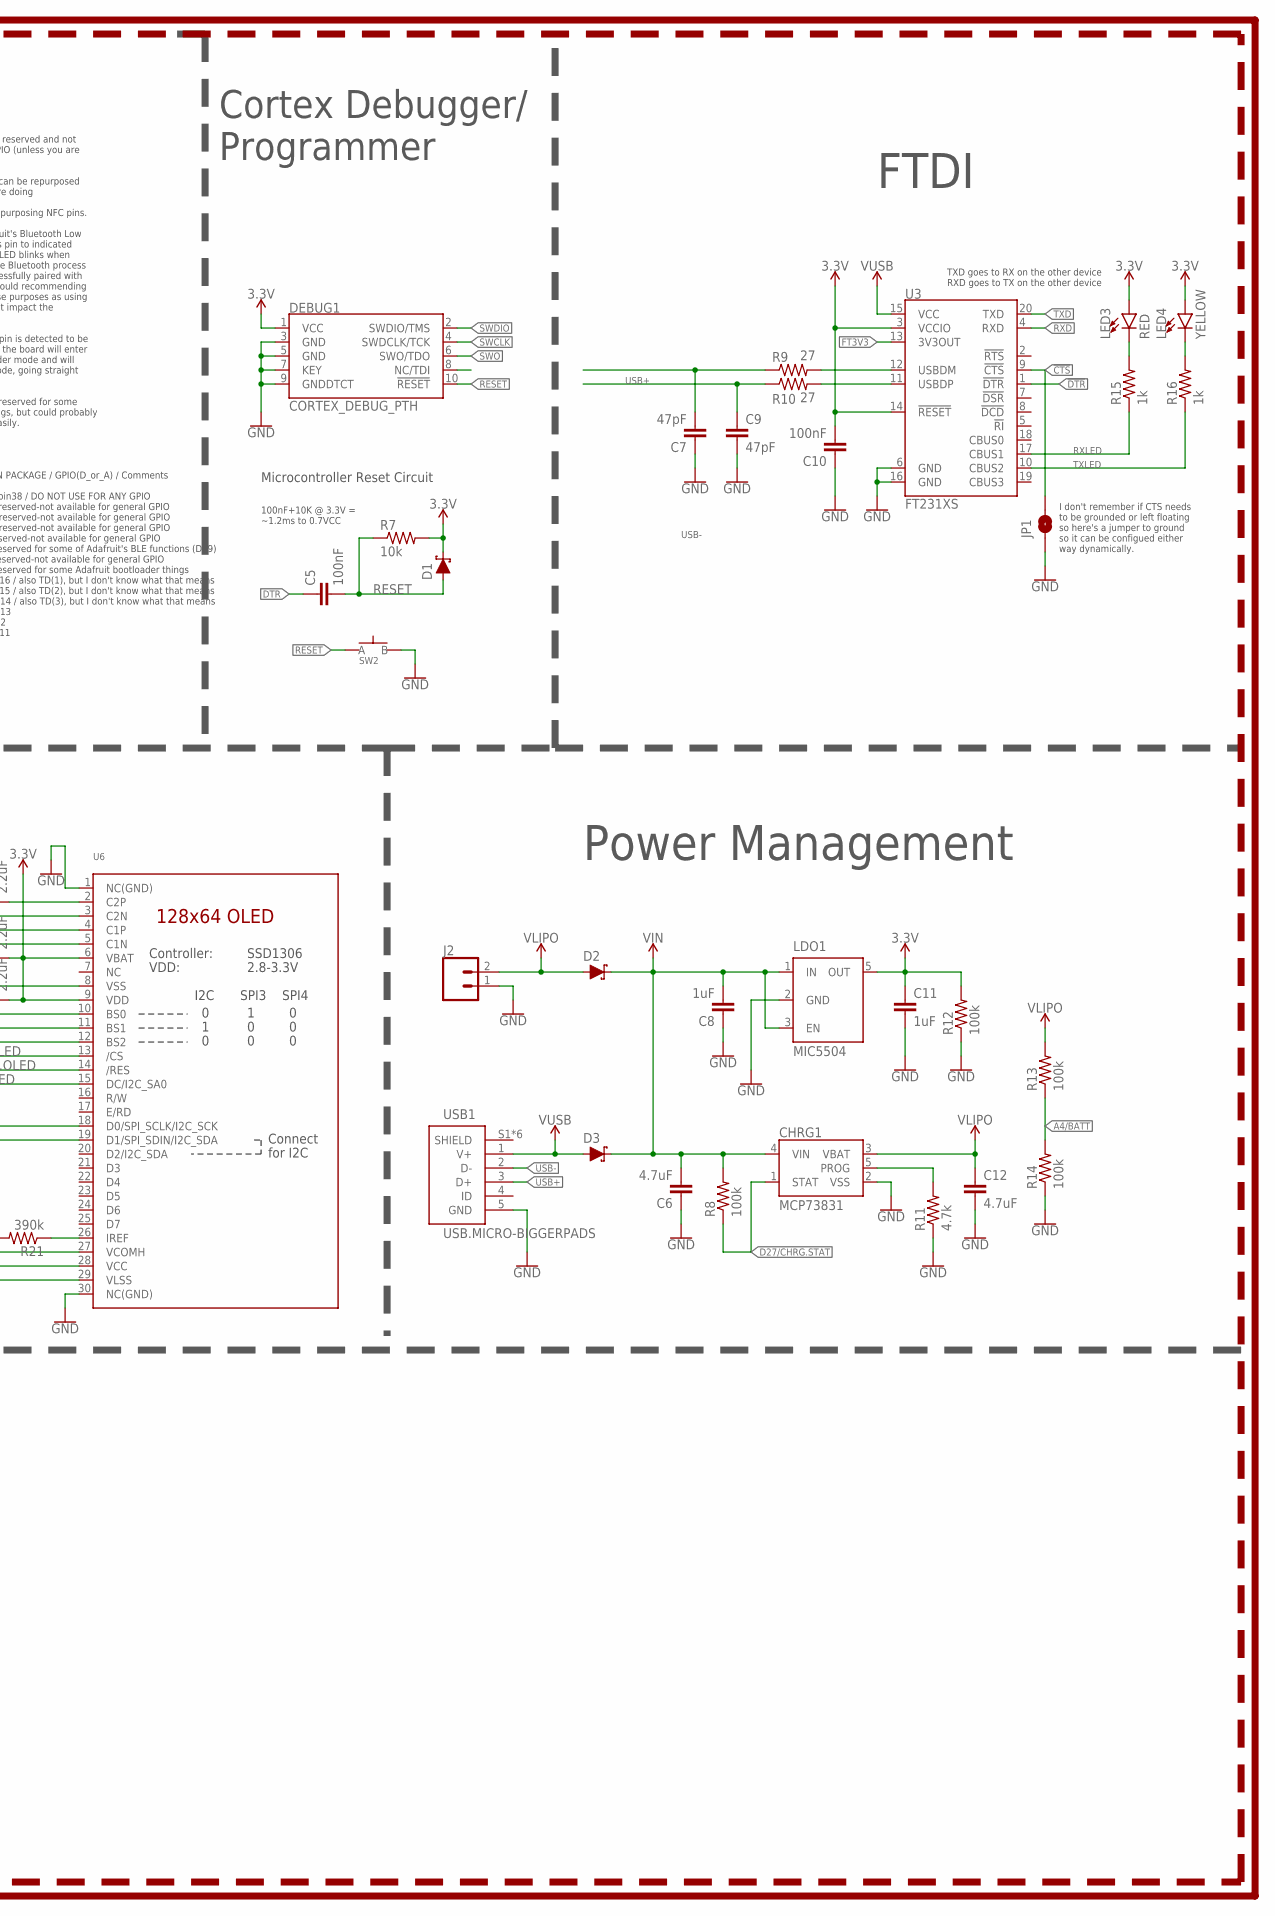
[picture p2: schematic Smartwatch-EXTRA-TOP.sch, part in row 1, column 2]

Parts:
C1, C8, C11, C16: 1uF; C0603
C2: 10uF; C0805
C3, C4: 12 pF; C0603
C5, C10, C14, C17: 100nF; C0603
C6, C12: 4.7uF; C0603
C7, C9: 47pF; C0603
C13: 2.2uF; C0603
C15: 10pF; C0603
C18, C19, C21, C22, C23: 2.2uF; C0402
C20: 10uF; C0603
CHRG1: MCP73831; SOT23-5
D1, D2, D3, D4: SCHOTTKY-USC; USC
DEBUG1: CORTEX_DEBUG_PTH; 2X5-PTH-1.27MM
J1: CONN_07-1.27MM; 1X07_1.27MM
J2: CONN_02; 1X02
J4: CONN_03.50MIL; 1X03_1.27MM
J5: CONN_10; 1X10_NO_SILK
J6: CONN_01; 1X01
JP1: JUMPER-SMT_2_NO_SILK; SMT-JUMPER_2_NO_SILK
L1: 10uH; L0603
LDO1: MIC5504; SOT23-5
LED1, LED3: RED; LED-0603
LED2: BLUE; LED-0603
LED4: YELLOW; LED-0603
M1: VIB.MOTOR.C0720B015F; WIRE.LEADS
Q1: NFET-AO3404A; SOT23-3
R1, R2, R7, R17, R18, R19, R20: 10k; R0603
R3, R4, R15, R16: 1k; R0603
R8, R12, R13, R14: 100k; R0603
R9, R10: 27; R0603
R11: 4.7k; R0603
R21: 390k; R0603
SW1, SW2: SPST-PTS830GG140-COPY.1-3; BUTTON-GULLWING
U1: NRF52832_MODULE_MDBT42; BLE_MODULE_RAYTAC_MDBT42
U3: FT231XS; SSOP20_L
U4: PHOTOTRANSISTOR; R0603
U5: MCP9808-MSOP8; MSOP08
U6: DISP_OLED_UG-2864HSWEG01-NO-WRAPAROUND; UG-2864HSWEG01_0.96IN_NO-WRAPAROUND
USB1: USB.MICRO-BIGGERPADS; USB-MICRO-01.BIGGERPADS
XTAL1: 32.768kHz; 2-SMD.NOLEAD.2.0MMTO1.2MM

Connections:
3: J5.5
3.3V: C2.2, C10.2, C11.1, C14.1, C15.2, C16.1, C17.1, C21.2, C23.2, D1.- (C), D4.- (C), DEBUG1.1 (VCC), J1.4, J5.1, LDO1.5 (OUT), LED3.A, LED4.A, M1.+, R1.2, R2.2, R7.2, R12.2, R18.2, U1.11 (VDD), U3.3 (VCCIO), U3.14 (!RESET), U4.1 (C), U5.8 (VDD), U6.6 (VBAT), U6.9 (VDD)
3.3VO: J5.2
!CTS: JP1.2, U3.9 (!CTS)
!DTR: U3.1 (!DTR)
A4/BATT: R13.1, R14.2, U1.5 (P0.28/AIN4)
A5/LIGHT: C13.1, R17.2, U1.6 (P0.29/AIN5), U4.2 (E)
A6/TIA: J1.5, U1.7 (P0.30/AIN6)
A7/PPG: J1.7, U1.8 (P0.31/AIN7)
A.IN: J4.1, U1.15 (P0.02/AIN0)
ALERT: R18.1, U5.3 (ALERT)
B.IN: J4.3, U1.20 (P0.07)
D3/RESET.OLED: J5.8, U1.16 (P0.03/AIN1), U6.14 (/RES)
D4/DC.OLED: J5.9, U1.17 (P0.04/AIN2), U6.15 (DC/I2C_SA0)
D10/LIT: J6.1, U1.23 (P0.10)
D11/MOTOR: Q1.1 (G), R19.2, U1.25 (P0.11)
D15/LED.CTRL: J1.6, U1.29 (P0.15)
D16/CS.OLED: J5.7, U1.30 (P0.16), U6.13 (/CS)
D27/CHRG.STAT: CHRG1.1 (STAT), R8.1, U1.4 (P0.27)
DFU: SW1.3 (B), U1.34 (P0.20)
DTR: C5.1
FRST: U1.38 (P0.22)
FT3V3: U3.13 (3V3OUT)
GND: C1.2, C2.1, C3.1, C4.2, C6.1, C7.1, C8.1, C9.2, C10.1, C11.2, C12.2, C13.2, C14.2, C16.2, C17.2, C20.1, C21.1, C22.1, C23.1, CHRG1.2 (VSS), DEBUG1.3 (GND), DEBUG1.5 (GND), DEBUG1.7 (KEY), DEBUG1.9 (GNDDTCT), J1.3, J2.1, J5.3, JP1.1, LDO1.2 (GND), LED1.C, LED2.C, Q1.2 (S), R11.1, R12.1, R14.1, R17.1, R19.1, R20.1, R21.2, SW1.1 (A), SW2.3 (B), U1.1 (GND), U1.12 (GND), U1.24 (GND), U1.39 (GND), U3.6 (GND), U3.16 (GND), U5.4 (GND), U5.5 (A2), U5.6 (A1), U5.7 (A0), U6.1 (NC(GND)), U6.8 (VSS), U6.10 (BS0), U6.12 (BS2), U6.29 (VLSS), U6.30 (NC(GND)), USB1.5 (GND)
LED1: R3.2, U1.31 (P0.17)
LED2: R4.2, U1.33 (P0.19)
MISO: U1.28 (P0.14)
MOM.BUTTON: J4.2, U1.18 (P0.05/AIN3)
MOSI: J5.6, U1.27 (P0.13), U6.19 (D1/SPI_SDIN/I2C_SDA)
unnamed: C3.2, U1.13 (P0.00/XL1), XTAL1.P$1 (1)
unnamed: R20.2, U6.11 (BS1)
unnamed: C4.1, U1.14 (P0.01/XL2), XTAL1.P$2 (2)
unnamed: R21.1, U6.26 (IREF)
unnamed: C18.2, U6.2 (C2P)
unnamed: LED1.A, R3.1
unnamed: LED2.A, R4.1
unnamed: L1.1, U1.10 (DCC)
unnamed: C1.1, L1.2, U1.9 (DEC4)
unnamed: C18.1, U6.3 (C2N)
unnamed: C19.2, U6.4 (C1P)
unnamed: CHRG1.5 (PROG), R11.2
unnamed: C19.1, U6.5 (C1N)
unnamed: C15.1, D4.+ (A), M1.-, Q1.3 (D)
unnamed: C20.2, U6.28 (VCC)
unnamed: C22.2, U6.27 (VCOMH)
unnamed: R9.2, U3.12 (USBDM)
unnamed: R10.2, U3.11 (USBDP)
unnamed: LED3.C, R15.2
unnamed: LED4.C, R16.2
P0.09/NFC1: U1.22 (P0.09)
RESET: C5.2, D1.+ (A), DEBUG1.10 (!RESET), R7.1, SW2.1 (A), U1.35 (P0.21/RESET)
RXD: U1.21 (P0.08), U3.4 (RXD)
RXLED: R15.1, U3.17 (CBUS1)
SCK: J5.4, U1.26 (P0.12), U6.18 (D0/SPI_SCLK/I2C_SCK)
SCL: J1.2, R2.1, U1.3 (P0.26), U5.2 (SCL)
SDA: J1.1, R1.1, U1.2 (P0.25), U5.1 (SDA)
SDCS: J5.10
SWCLK: DEBUG1.4 (SWDCLK/TCK), U1.36 (SWDCLK)
SWDIO: DEBUG1.2 (SWDIO/TMS), U1.37 (SWDIO)
SWO: DEBUG1.6 (SWO/TDO), U1.32 (P0.18/SWO)
TXD: U1.19 (P0.06), U3.20 (TXD)
TXLED: R16.1, U3.10 (CBUS2)
USB+: C9.1, R10.1, USB1.3 (D+)
USB-: C7.2, R9.1, USB1.2 (D-)
VIN: C6.2, C8.2, CHRG1.4 (VIN), D2.- (C), D3.- (C), LDO1.1 (IN), LDO1.3 (EN), R8.2
VLIPO: C12.1, CHRG1.3 (VBAT), D2.+ (A), J2.2, R13.2
V_USB: D3.+ (A), U3.15 (VCC), USB1.1 (V+)

Notes on the sheet:
Microcontroller Reset Circuit
100nF+10K @ 3.3V = ~1.2ms to 0.7VCC
SPECIAL / PORT / PIN ON PACKAGE / GPIO(D_or_A) / Comments SDA / P0.25 / pin2 / D25 SCL / P0.26 / pin3 / D26 none / P0.27 / pin4 / D27 none / P0.28 / pin5 / D28_or_A4 / (low drive, low frequency IO) none / P0.29 / pin6 / D29_or_A5 / (low drive, low frequency IO) none / P0.30 / pin7 / D30_or_A6 none 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
SPECIAL / PORT / PIN ON PACKAGE / GPIO(D_or_A) / Comments none / P0.02 / pin15 / D2_or_A0 none / P0.03 / pin16 / D3_or_A1 none / P0.04 / pin17 / D4_or_A2 none / P0.05 / pin18 / D5_or_A3 TXD / P0.06 / pin19 / D6 / but reserved for Serial communication and programming none / P0.07 / pin20 / D7 RXD / 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
SPECIAL / PORT / PIN ON PACKAGE / GPIO(D_or_A) / Comments Factory Reset / P0.22 / pin38 / DO NOT USE FOR ANY GPIO SWDIO / none / pin37 / reserved-not available for general GPIO SWCLK / none / pin36 / reserved-not available for general GPIO RESET / P0.21 / pin35 / reserved-not available for general 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
Some pins are noted as reserved and not available for general GPIO (unless you are an adavanced user) I2C, SPI, and SWD pins can be repurposed if you know what you are doing For Milestones, avoid repurposing NFC pins. For P0.19 (LED2), Adafruit's Bluetooth Low Energy libraries use this pin to indic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
PIN_DFU / P0.20: If this pin is detected to be at GND level at startup, the board will enter a special serial bootloader mode and will not execute any user code, going straight into bootloader mode. If you wish to use this pin as a standard GPIO, make sure that it is pulled high with a pullup resis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
Additional notes for advanced users only
TXD goes to RX on the other device RXD goes to TX on the other device
I don't remember if CTS needs to be grounded or left floating so here's a jumper to ground so it can be configued either way dynamically.
Header Pins
nRF2832
Temperature Sensor
Cortex Debugger/ Programmer
FTDI
Power Management
Outputs a voltage relative to incident light. Will need to calibrate RL to based on the desired dynamic range.
I2C Adress: A0,A1,A2 connected to ground: 0x18 Other addresses: 0x19 to 0x1F
Bypass Capacitors
One C should probably equal 1-10 uF; choose value to minimize unique components. The other is 100nF C provides power stability when the motor turns on and off
Re-name "GPIO" with actual pin name/number; Must match name on microprocessor
Vibration Motor
Ambient Light Sensor

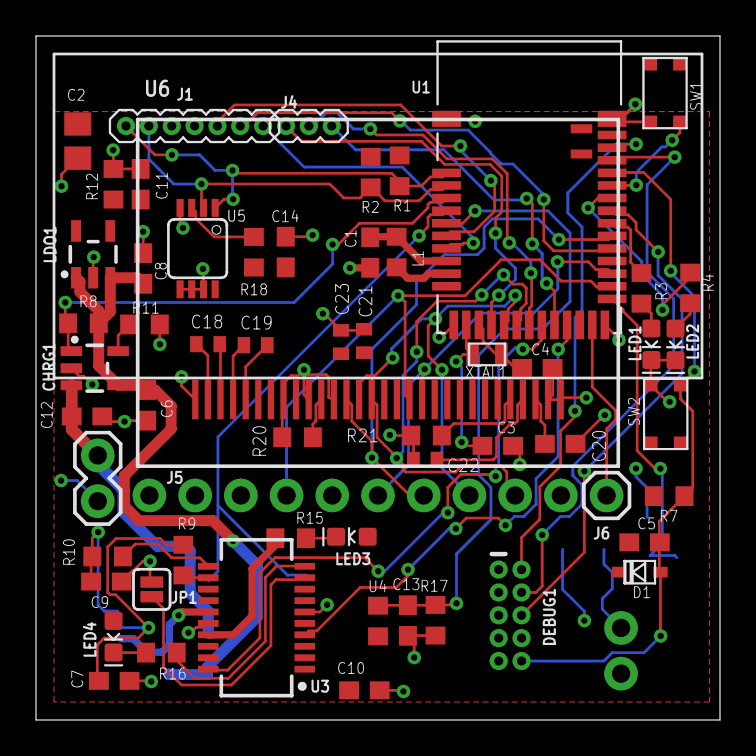
[picture p3: board Smartwatch-EXTRA-TOP.brd from above]

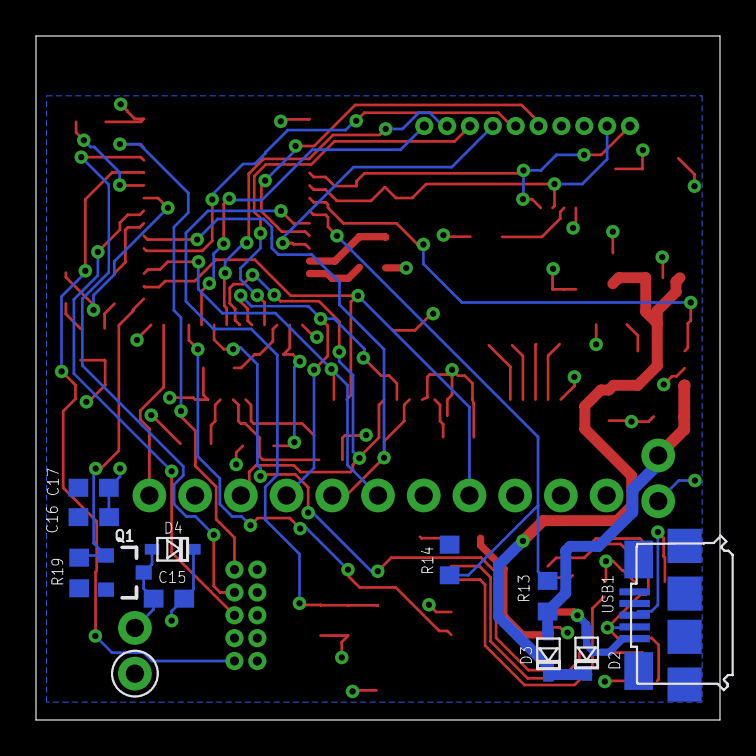
[picture p4: board Smartwatch-EXTRA-TOP.brd from below]

Board: 2 copper layers, 38.0 x 38.0 mm, 71 parts (12 on the bottom side), 58 nets.
