RuhaanSJ/Smartwatch/Hardware/Extra/Bottom/Smartwatch-EXTRA-BOTTOM.brd

## EAGLE design Hardware/Extra/Bottom/Smartwatch-EXTRA-BOTTOM.brd (2021-04-10)

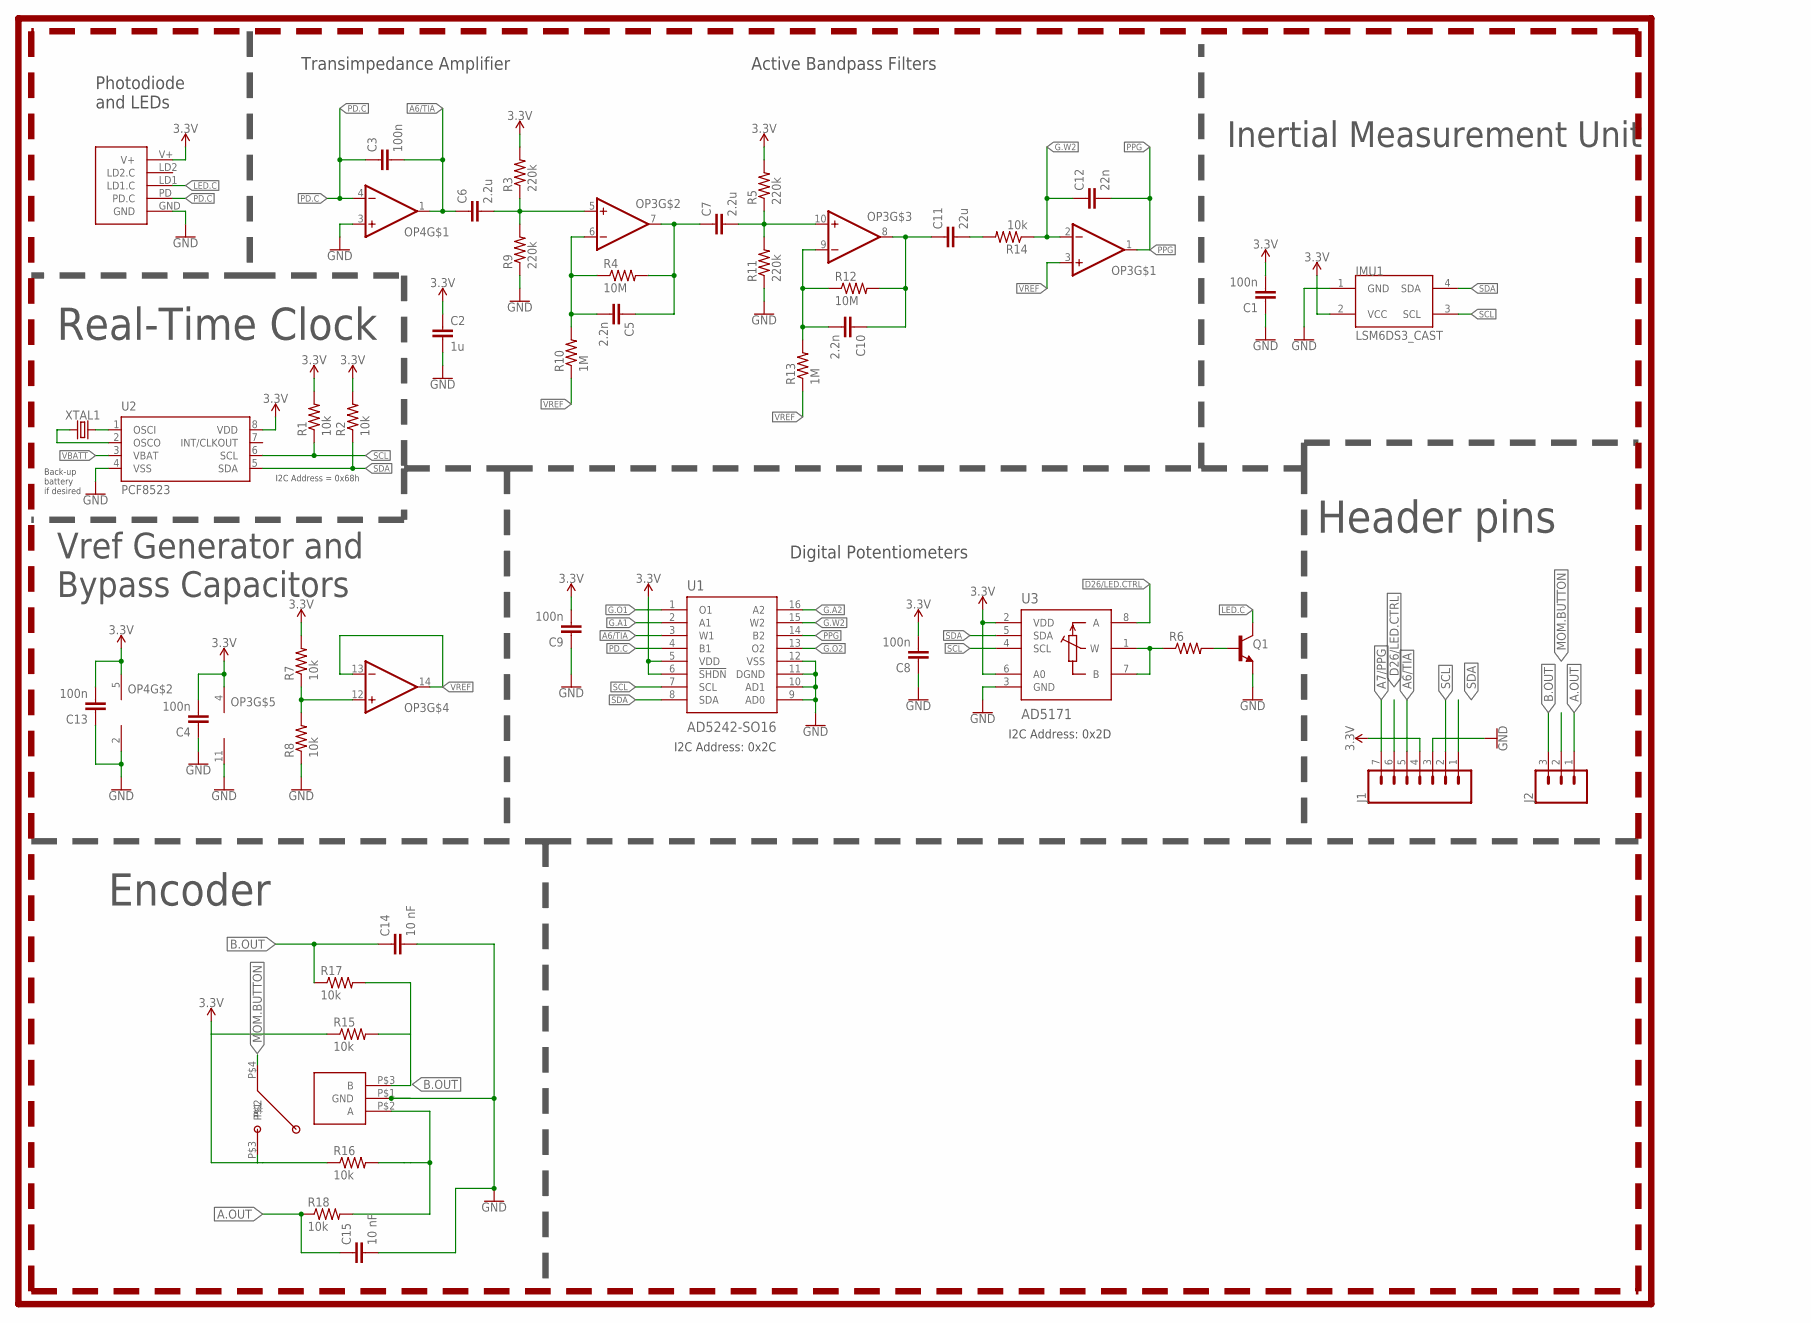
[picture p5: schematic Smartwatch-EXTRA-BOTTOM.sch]

Parts:
B1: SWITCH
C1, C3, C4, C8, C9, C13: 100n; C0603
C2: 1u; C0603
C5, C10: 2.2n; C0603
C6, C7: 2.2u; C0603
C11: 22u; C0603
C12: 22n; C0603
C14, C15: 10 nF; C0603
ENC1: EVQVU
IMU1: LSM6DS3_CAST
J1: CONN_07-1.27MM; 1X07_1.27MM
J2: CONN_03.50MIL; 1X03_1.27MM
OP3: OP-QUAD-SO14; SO14
OP4: OP-SINGLEOT; SOT23-5
Q1: NPN-GENERIC; SOT23-3
R1, R2, R14, R15, R16, R17, R18: 10k; R0603
R3, R5, R9, R11: 220k; R0603
R4, R12: 10M; R0603
R6: RESISTOR0603; R0603
R7, R8: 10k; R0402
R10, R13: 1M; R0603
U1: AD5242-SO16; SO16
U2: PCF8523; SO8; DIGIKEY 568-5306-1-ND
U3: AD5171; SOT-23-8
U4: PPG.MODULE.2
XTAL1: 32.7680kHz; 2-SMD.NOLEAD.2.0MMTO1.2MM

Connections:
3.3V: B1.P$3, C1.2, C2.1, C4.2, C8.2, C9.2, C13.2, IMU1.2 (VCC), J1.4, OP3.4 (V+), OP4.5 (V+), R1.2, R2.2, R3.2, R5.2, R7.2, R15.1, R16.1, U1.5 (VDD), U1.6 (!SHDN), U2.8 (VDD), U3.2 (VDD), U3.6 (A0), U4.V+
A6/TIA: C3.2, C6.1, J1.5, OP4.1 (OUT), U1.3 (W1)
A7/PPG: J1.7
A.OUT: C15.1, ENC1.P$2 (A), J2.1, R16.2, R18.1, R18.2
B.OUT: C14.1, ENC1.P$3 (B), J2.3, R17.1
D26/LED.CTRL: J1.6, U3.8 (A)
G.A1: U1.2 (A1)
G.A2: U1.16 (A2)
G.O1: U1.1 (O1)
G.O2: U1.13 (O2)
G.W2: C12.1, OP3.2 (-IN), R14.1, U1.15 (W2)
GND: C1.1, C2.2, C4.1, C8.1, C9.1, C13.1, C14.2, C15.2, ENC1.P$1 (GND), IMU1.1 (GND), J1.3, OP3.11 (V-), OP4.2 (V-), OP4.3 (+IN), Q1.2 (E), R8.1, R9.1, R11.1, U1.9 (AD0), U1.10 (AD1), U1.11 (DGND), U1.12 (VSS), U2.4 (VSS), U3.3 (GND), U4.GND
LED.C: Q1.3 (C), U4.LD1 (LD1.C)
MOM.BUTTON: B1.P$4, J2.2
unnamed: U2.2 (OSCO), XTAL1.P$1 (1)
unnamed: U2.1 (OSCI), XTAL1.P$2 (2)
unnamed: R15.2, R17.2
unnamed: Q1.1 (B), R6.2
unnamed: R6.1, U3.1 (W), U3.7 (B)
unnamed: OP3.12 (+IN), R7.1, R8.2
unnamed: C6.2, OP3.5 (+IN), R3.1, R9.2
unnamed: C5.2, OP3.6 (-IN), R4.1, R10.2
unnamed: C5.1, C7.1, OP3.7 (OUT), R4.2
unnamed: C7.2, OP3.10 (+IN), R5.1, R11.2
unnamed: C10.2, OP3.9 (-IN), R12.1, R13.2
unnamed: C10.1, C11.1, OP3.8 (OUT), R12.2
unnamed: C11.2, R14.2
PD.C: C3.1, OP4.4 (-IN), U1.4 (B1), U4.PD (PD.C)
PPG: C12.2, OP3.1 (OUT), U1.14 (B2)
SCL: IMU1.3 (SCL), J1.2, R1.1, U1.7 (SCL), U2.6 (SCL), U3.4 (SCL)
SDA: IMU1.4 (SDA), J1.1, R2.1, U1.8 (SDA), U2.5 (SDA), U3.5 (SDA)
VBATT: U2.3 (VBAT)
VREF: OP3.3 (+IN), OP3.13 (-IN), OP3.14 (OUT), R10.1, R13.1

Notes on the sheet:
Photodiode and LEDs
Active Bandpass Filters
Digital Potentiometers
Transimpedance Amplifier
I2C Address: 0x2C
I2C Address: 0x2D
I2C Address = 0x68h
Back-up battery if desired
Real-Time Clock
Vref Generator and Bypass Capacitors
Header pins
Inertial Measurement Unit
Encoder

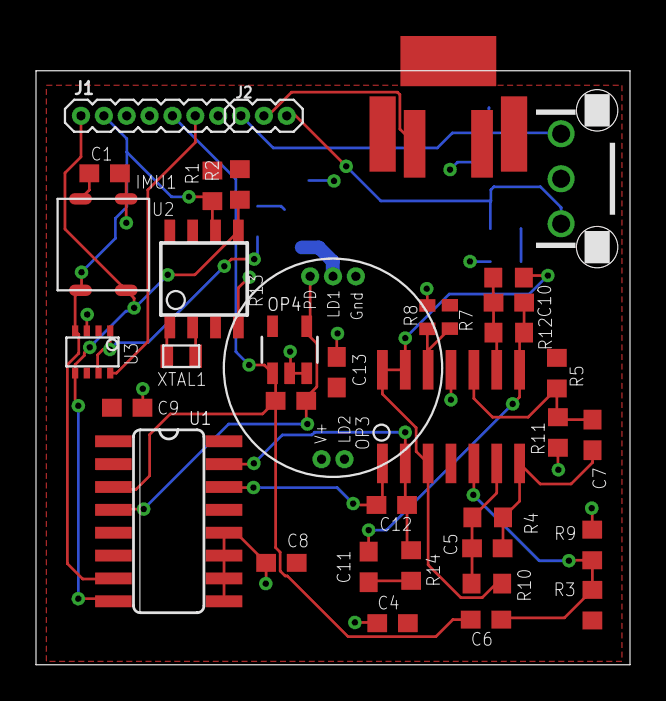
[picture p6: board Smartwatch-EXTRA-BOTTOM.brd from above]

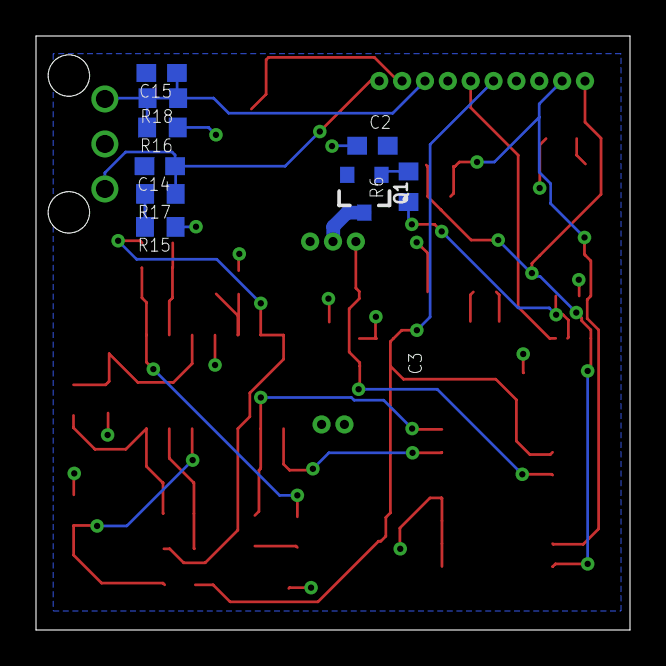
[picture p7: board Smartwatch-EXTRA-BOTTOM.brd from below]

Board: 2 copper layers, 33.0 x 33.0 mm, 46 parts (9 on the bottom side), 27 nets.
