RuhaanSJ/Smartwatch/(commit log)

2021-02-13 This group contains elements or signals that cannot be deleted,as the operation cannot be back-annotated
    [Smartwatch-BASIC-TOP.brd, Smartwatch-BASIC-TOP.sch]
2021-02-13 USB, OLED Microcontroller and SD added. Need to add RTC
    [Smartwatch-BASIC-TOP.brd, Smartwatch-BASIC-TOP.sch]
2021-02-13 USB, OLED Microcontroller, SD and RTC added
    [Smartwatch-BASIC-TOP.brd, Smartwatch-BASIC-TOP.sch]
2021-02-15 Added FTDI
    [Smartwatch-BASIC-BOTTOM.brd, Smartwatch-BASIC-BOTTOM.sch, Smartwatch-BASIC-TOP.brd, Smartwatch-BASIC-TOP.sch]
2021-02-17 Bottom board routed
    [Smartwatch-BASIC-BOTTOM.brd, Smartwatch-BASIC-BOTTOM.sch, Smartwatch-BASIC-TOP.brd, Smartwatch-BASIC-TOP.sch]
2021-02-20 Top board routing started
    [Smartwatch-BASIC-TOP.brd]
2021-02-21 Top Board Routed
    [Smartwatch-BASIC-TOP.brd, Smartwatch-BASIC-TOP.sch]
2021-02-27 Rearranging Top Board
    [Smartwatch-BASIC-BOTTOM.brd, Smartwatch-BASIC-BOTTOM.sch, Smartwatch-BASIC-TOP.brd]
2021-02-27 Rearranged Top Board
    [Smartwatch-BASIC-TOP.brd]
2021-03-06 Fixing top board issues
    [Smartwatch-BASIC-TOP.brd]
2021-03-06 Top Board Complete
    [Smartwatch-BASIC-TOP.brd]
2021-03-06 Bottom Board Complete
    [Smartwatch-BASIC-BOTTOM.brd]
2021-03-06 Organized Schematics and Silkscreens for both boards
    [Smartwatch-BASIC-BOTTOM.brd, Smartwatch-BASIC-BOTTOM.sch, Smartwatch-BASIC-TOP.brd, Smartwatch-BASIC-TOP.sch]
2021-03-07 Fixed Top Board Issue
    [Smartwatch-BASIC-BOTTOM.sch, Smartwatch-BASIC-TOP.brd]
2021-03-07 Fixed Bottom Board Issue
    [Smartwatch-BASIC-BOTTOM.brd]
2021-03-07 Started wokring on Extra features
    [Smartwatch-BASIC-PPG.brd, Smartwatch-BASIC-PPG.sch, Smartwatch-BASIC-PPG_BOM.xlsx, Smartwatch-EXTRA-BOTTOM.brd, Smartwatch-EXTRA-BOTTOM.sch, Smartwatch-EXTRA-BOTTOM_BOM.xlsx, Smartwatch-EXTRA-TOP.brd, Smartwatch-EXTRA-TOP.sch]
2021-03-14 Fixed Top Board Polygon
    [Smartwatch-BASIC-TOP.brd]
2021-03-18 Fixed Bottom Board Mistakes
    [Smartwatch-BASIC-BOTTOM.brd, Smartwatch-BASIC-PPG.brd, Smartwatch-BASIC-PPG.sch, Smartwatch-BASIC-PPG_BOM.xlsx]
2021-03-18 Top board fixed some traces
    [Smartwatch-BASIC-TOP.brd]
2021-03-20 Top Board- Minor problems correct
    [Smartwatch-BASIC-TOP.brd]
2021-03-20 PPG Board Added
    [Smartwatch-PPG-Module-BOM.xlsx, Smartwatch-PPG-Module.brd, Smartwatch-PPG-Module.sch]
2021-03-20 Header Pins Fixed
    [Smartwatch-BASIC-BOTTOM.brd, Smartwatch-BASIC-BOTTOM.sch, Smartwatch-BASIC-TOP.brd, Smartwatch-BASIC-TOP.sch]
2021-03-20 Top Board airwire fixed
    [Smartwatch-BASIC-TOP.brd, Smartwatch-BASIC-TOP.sch]
2021-03-20 Top Board BOM WIP
    [Smartwatch-BASIC-TOP.brd, Smartwatch-BASIC-TOP.sch, Smartwatch-BASIC-TOP_BOM.xlsx]
2021-03-22 Extra features updated
    [Smartwatch-BASIC-PPG.brd, Smartwatch-BASIC-PPG.sch, Smartwatch-BASIC-PPG_BOM.xlsx, Smartwatch-EXTRA-BOTTOM.brd, Smartwatch-EXTRA-BOTTOM.sch, Smartwatch-EXTRA-BOTTOM_BOM.xlsx, Smartwatch-EXTRA-TOP.brd, Smartwatch-EXTRA-TOP.sch]
2021-03-24 Extra Silkscreens updated
    [Smartwatch-EXTRA-BOTTOM.brd, Smartwatch-EXTRA-BOTTOM.sch, Smartwatch-EXTRA-TOP.brd, Smartwatch-EXTRA-TOP.sch]
2021-03-27 Encoder Added, Silkscreen Updated, Bom Updated
    [Smartwatch-EXTRA-BOTTOM.brd, Smartwatch-EXTRA-BOTTOM.sch, Smartwatch-EXTRA-BOTTOM_BOM.xlsx]
2021-03-27 Microphone Removed,Silkscreen Updated, Bom Updated
    [Smartwatch-EXTRA-TOP.brd, Smartwatch-EXTRA-TOP.sch, Smartwatch-EXTRA-TOP_BOM.xlsx]
2021-03-27 Board Resized and Repositioned
    [Smartwatch-AUX1-Module-BOM.xlsx, Smartwatch-EXTRA-AUX1.brd, Smartwatch-EXTRA-AUX1.sch]
2021-03-27 BOMs finished
    [Smartwatch-EXTRA-BOTTOM_BOM.xlsx, Smartwatch-EXTRA-TOP.brd, Smartwatch-EXTRA-TOP.sch, Smartwatch-EXTRA-TOP_BOM.xlsx]
2021-04-01 Encoder changed, BOMs updated
    [Smartwatch-EXTRA-AUX1.brd, Smartwatch-EXTRA-AUX1.sch, Smartwatch-EXTRA-BOTTOM.brd, Smartwatch-EXTRA-BOTTOM.sch, Smartwatch-EXTRA-BOTTOM_BOM.xlsx, Smartwatch-EXTRA-TOP.brd, Smartwatch-EXTRA-TOP.sch, Smartwatch-EXTRA-TOP_BOM.xlsx]
2021-04-03 Removed GPS, rearranged some other components
    [Smartwatch-EXTRA-TOP.brd, Smartwatch-EXTRA-TOP.sch]
2021-04-03 GPS Removed, added back original display, kept pads for adafruit display
    [Smartwatch-AUX1-Module-BOM.xlsx, Smartwatch-BASIC-BOTTOM.brd, Smartwatch-BASIC-BOTTOM.sch, Smartwatch-BASIC-BOTTOM_BOM.xlsx, Smartwatch-BASIC-TOP_BOM.xlsx, Smartwatch-EXTRA-AUX1.brd, Smartwatch-EXTRA-AUX1.sch, Smartwatch-EXTRA-BOTTOM.brd]
2021-04-10 Silkscreens fixed, Airwires removed
    [Smartwatch-EXTRA-BOTTOM.brd, Smartwatch-EXTRA-TOP.brd]
